BartRijvers11/WiFiTimelapse/Photos/tripod_detail2.jpg

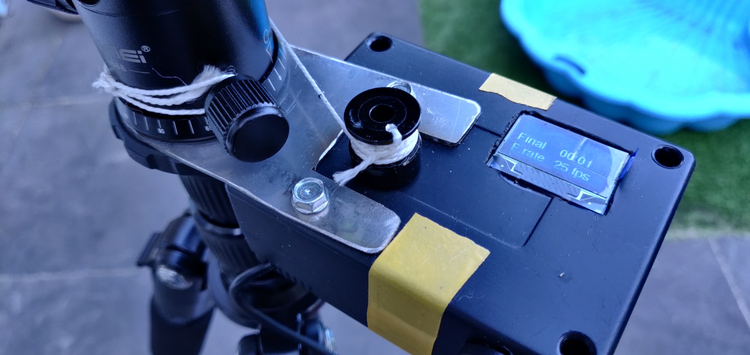
Photos/tripod_detail2.jpg
