BartRijvers11/WiFiTimelapse/Photos/tripod_detail.jpg

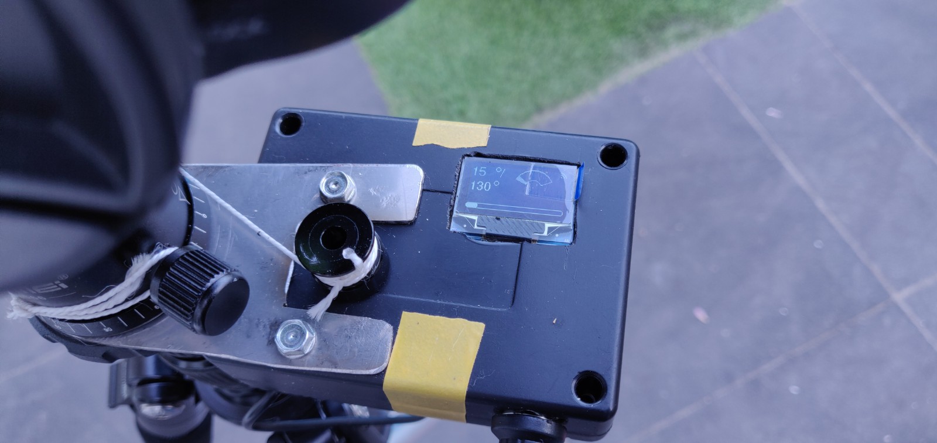
Photos/tripod_detail.jpg
