BartRijvers11/WiFiTimelapse/(commit log)

2020-05-01 First upload version, fully functional
    Sometimes, I see a brownout when re-connecting WiFi, but almost always at startup
    [WiFiTimeLapse.ino]
2020-05-01 Graphic connection schematics
